joshkunz/co2-sensor/frontend/readme.md

# Frontend

This directory contains the implementation of the sensor management frontend
exposed by the CO2 sensor backend server.

The frontend is built using React, with Bootstrap for components and style.

## Developing

* Dev Server: `yarn serve`
* Testing: `yarn test`
* Stand-Alone type checking: `yarn typecheck`
