joshkunz/co2-sensor/hardware/case.stl

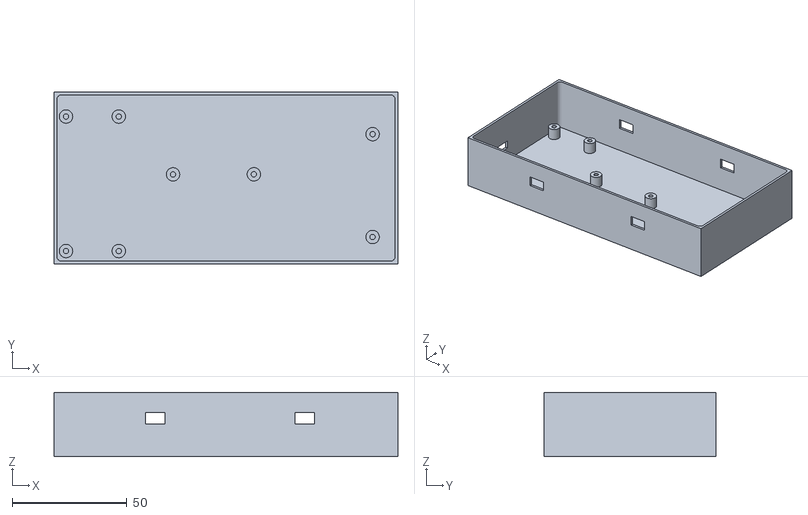
[picture p2: CAD file, 2021-02-08]
hardware/case.stl
150.0 x 75.0 x 28.0
