joshkunz/co2-sensor/hardware/lid.stl

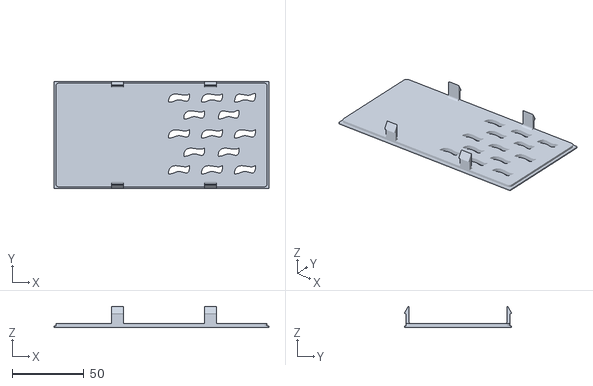
[picture p3: CAD file, 2021-02-08]
hardware/lid.stl
150.0 x 75.0 x 15.0
