joshkunz/co2-sensor/(commit log)

2021-01-08 Initial Commit: Adds wire library.
2021-01-09 Implement response types for wire protocol.
2021-01-10 Improved UART read handling. Doesn't guess.
    [device.rs, main.rs, wire.rs]
2021-01-11 Clean up the device interface.
2021-01-11 Export sensor metrics via the prometheus interface.
2021-01-14 Add tests for reading CO2/Elevation.
    This adds some much-needed testing to the device interaction.
2021-01-22 Test to wait for sensor warmup.
    Also runs `cargo fmt`.
2021-01-24 CO2 calibration sequence + test
2021-01-24 Small doc fixes + a small helper for Status
    [wire.rs]
2021-02-08 Add initial frontend mockup.
    Now that I understand roughly how frontend dev works, this change adds
    a basic working frontend with a functional "calibrator" widget, and
    a non-functional PPM display.
2021-02-08 Add hardware designs for the case + lid.
    [case.stl, lid.stl]
2021-03-07 Add server with prometheus results + tests.
    The goal of this change is to start abstracting out the server component
    into a testable module. It's also designed with calibration support
    in-mind. Calibration is a bit tricky, because we can't take measurements
    while the device is calibrating.
2021-03-07 Implement /calibrate endpoint.
    Also implements the `is_ready` endpoint in the manager.
2021-03-07 Wire up the /isready endpoint.
2021-03-18 docs: Document build/wiring/running.
2021-03-20 Add Elevation input in calibration dialog.
2021-03-20 Re-Write calibrator using hooks + XState.
    IMO this is much cleaner, because the effect cleanup is attached
    directly to the effect. I also like that the state machine is much
    more readable.
2021-03-20 Add elevation validation in the landing form.
2021-03-20 Add current elevation fetching to elevation dialog.
2021-03-21 frontend: Actually send elevation on calibrate.
2021-03-21 backend: Re-write HTTP server with gotham.
    Warp has a unique and interesting API, but understanding the type errors
    was insane. It's a huge mess of closed types, and it was impossible to
    understand what was going wrong, even when doing simple stuff like
    trying to change routes based on server config.
    Gotham was *much* easier to get going with, and I can kinda understand
    the API.
    [main.rs, server.rs]
2021-03-21 backend: Support reading device's configured elevation.
2021-03-21 backend: Fixup the dir path.
    [main.rs, server.rs]
2021-03-21 backend: Fix device calibration workflow.
    [device.rs]
2021-03-21 backend: Add extra device status check after calibration.
    This should give extra confidence that the device has returned to
    a known-good state.
2021-03-21 backend: Print extra information at startup.
    Also add another sanity check to make sure the device is in a normal
    operating state before we start serving.
2021-03-21 backend: Add error logging.
    [main.rs, server.rs]
2021-03-22 backend: Bump device read timeout to 15s for reliability.
